gwidongOk/2026ALTIS/document/2026ALTIS V3 시험발사 운용 시나리오.docx

2026 ALTIS V3 아비오닉스 시험발사 운용 시나리오

대상 펌웨어: Final_v3/src/main.cpp | 문서 기준일: 2026-07-05

# 1. 발사 시퀀스

명령 | 응답 | 비고
CALIBRATE (센서보정) | CALIBRATION DONE. + beep 실패: IMU NOISY - RETRYING... + beep×3 | 수직 고정 후 실행
ERASE (플래시소거) | ERASING FLASH... → DONE. + beep | 이전 데이터 삭제
READY (발사준비) | READY CONVERGING - WAIT FOR ARMED 실패: KF ALIGN RETRY/BARO UNSTABLE + beep×3 | 보정·소거 선행 필수 홀센서 HIGH(결합) 아니면 거부 발사각 상태일 때 사용
(자동) 무장 | ARMED - LAUNCH DETECTION ACTIVE + beep×2 | 약 1분 소요, 흔들지 말 것
(자동) 발사확정 | LAUNCH CONFIRMED | 오 탐지 시 무장 전 단계로 자동 복귀
STOP (강제정지) | STOPPED. + beep×2 | 회수할떄 실행 (램에 있는 데이터 flash memory에 저장)
PARSE (로그덤프) | DUMP START → DUMP DONE | 후처리용 데이터 추출

# 2. 기타 명령

명령 | 사용 시점 | 응답
REBOOT(재부팅) | 언제나 | IMU+BARO OK → 1-AXIS READY
DISARM(무장해제) | 비행 중 제외 | DISARMED + beep(비행 중엔 ACK만, 무시됨)
TEST SERVO | 대기 상태 | SERVO OK + beep×2
TEST PYRO1(2단) | 대기 상태 | beep×3 → 1초 대기 → PYRO1 DONE
TEST PYRO2(메인) | 대기 상태 | beep×3 → 1초 대기 → PYRO2 DONE

# 3. 비행 중 자동 시퀀스

단계 | 전이 조건 | 동작
추진비행 → 관성비행 | 비력<2m/s² & 속도>10m/s, 또는 2초 경과 | BO
관성비행 | 홀센서 LOW (연속 3회) + 기울기 45도 이내 | STAGE2 IGN (1회) ※ 45도 초과: NSC TILT (영구보류)
관성비행 → 하강 | 상승속도<-0.5m/s & 고도>15m, 3번 연속 | APG, DROGUE※ 단분리 미확인 시 NSC NOSEP
하강 | 고도<100m | MAIN
하강 → 착륙완료 | 고도<10m & 속도<1m/s, 1초 | LAND, STOPPED. (로깅종료, beep×3)

# 4. 부저 신호

상황 | 패턴 | 의미
초기화 실패 | 0.1초×3, 이후 정지 | 재부팅 전까지 복구 불가
초기화 완료 / 보정 완료 / 파이로시험 완료 | 0.2초×1 | -
보정·정렬·영점 재시도 | 0.1초×3 | 자동 재시도 중
플래시소거 완료 | 0.5초×1 | -
서보시험 완료 / 무장 전환 | 0.1초×2 | -
파이로시험 점화 전 경고 | 0.05초×3 | 1초 후 점화
준비(수렴) 진입 / 강제정지 완료 | 0.2초×2 | -
무장해제 완료 | 0.1초×1 | -
착륙 자동감지 | 0.5초×3 | 로깅 자동 종료

# 5. 체크리스트

단계 | 확인 사항
전원 인가 | IMU+BARO OK / 1-AXIS READY 확인
보정 전 | 발사각 수직 고정, 흔들림 없음
파이로 시험 | 이매치 분리 후에만 실행
READY 전 | 보정·소거 완료 + 홀센서 결합상태(HIGH) 확인
무장 대기(~1분) | 기체 고정 유지, 흔들지 말 것
회수 직후 | STOP → 전원 차단
