gwidongOk/2026ALTIS/document/2차 시험발사 이후 피드백.pptx

해결방안
Calibrate -> Ready ->start
Ready시 초기자세와 초기고도만 가속도와 기압계센서로 측정 후 저장
Start시 자세적분, KF 실행
Start 명령이후 단기간안에 발사로 드리프트를 최소화

문제점
Calibrate -> start
Strat 이후는 KF, 밑 자세 적분 , launch 감지 전부 다 시작중
-> 이로 인해 자세에서 자세 적분으로 드리프트 발생

단계
초기자세 | 5.523 deg
Lauch 시점 자세 | 22.922 deg

## Slide 2

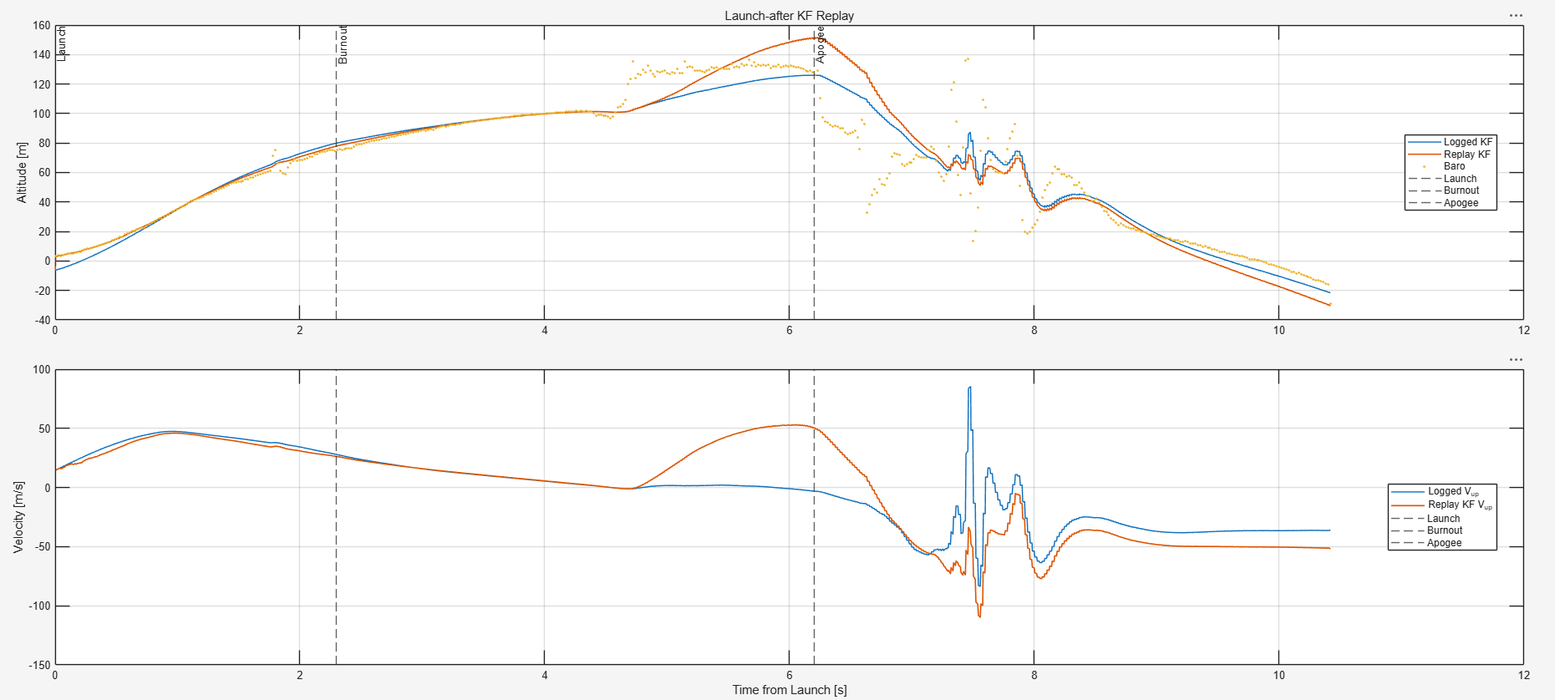
[picture p1: figure]
