gwidongOk/2026ALTIS/matlab/noise/baro_편향제거png.png

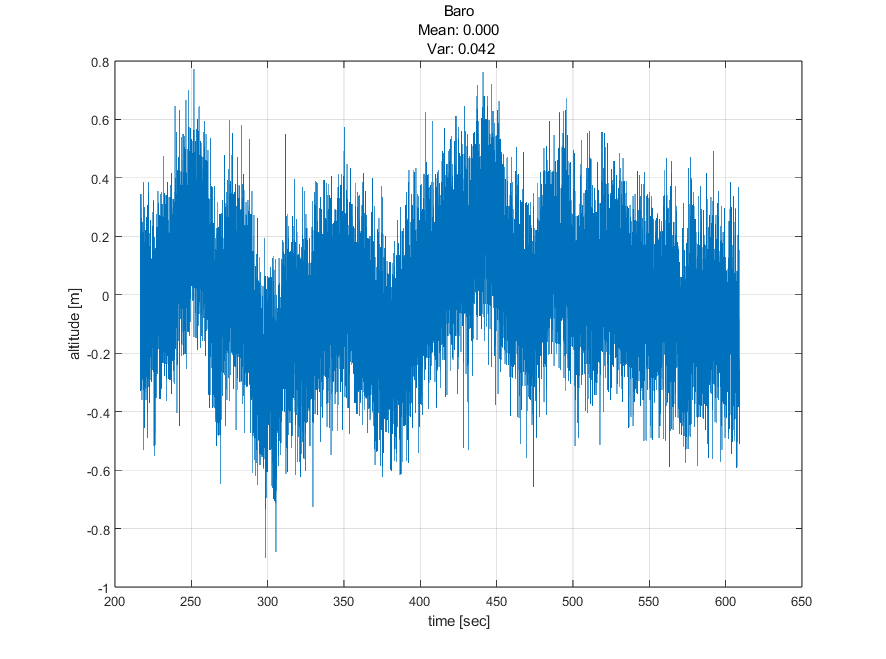
matlab/noise/baro_편향제거png.png
