gwidongOk/2026ALTIS/matlab/scenari/1D KF Monte Carlo_2.png

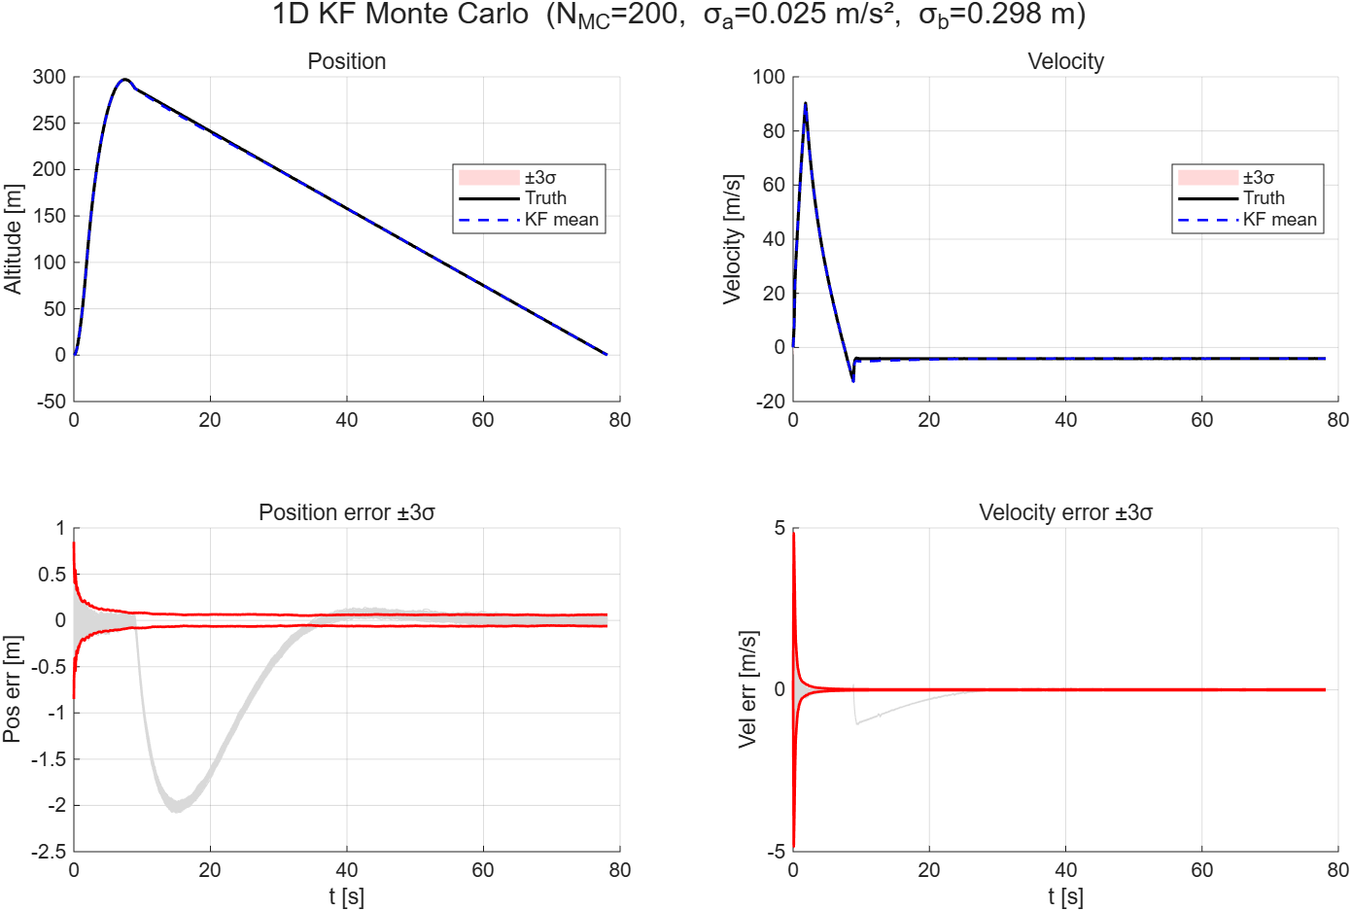
matlab/scenari/1D KF Monte Carlo_2.png
