gwidongOk/2026ALTIS/matlab/scenari/Fixed Q vs Adaptive Q.png

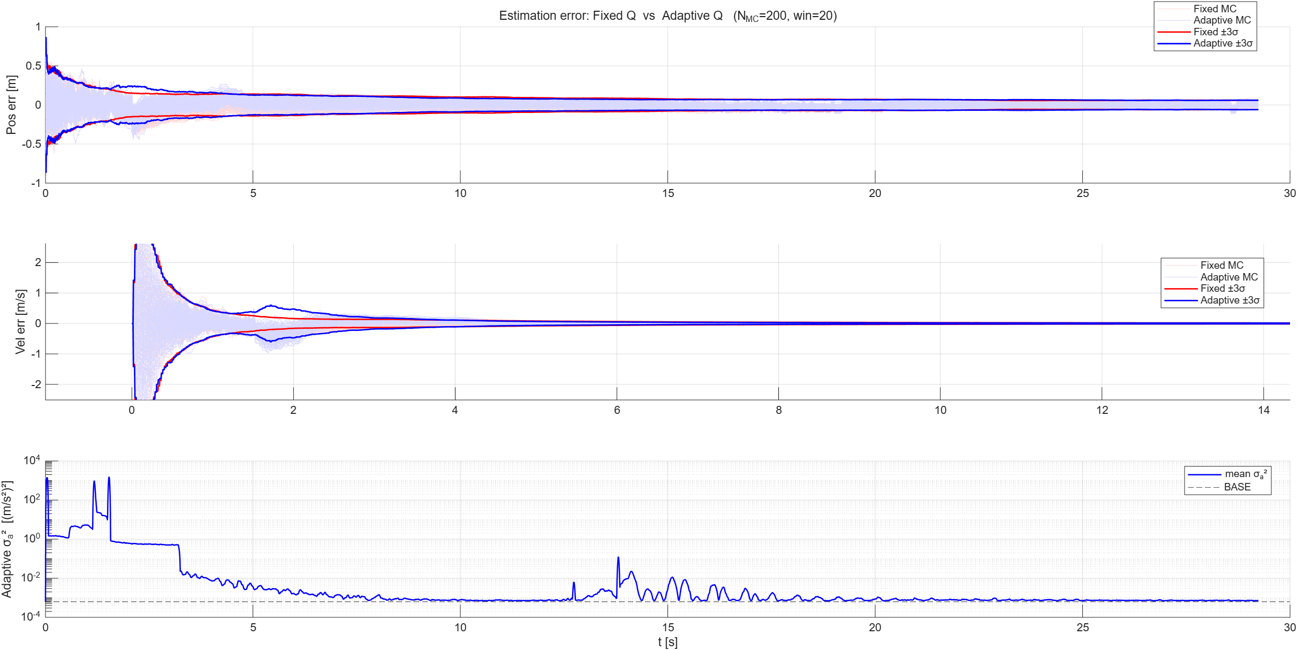
matlab/scenari/Fixed Q vs Adaptive Q.png
