gwidongOk/2026ALTIS/HW/BOM_PCB2_1_2026-06-29.xlsx

No. | Quantity | Comment | Designator | Footprint | Value | Manufacturer Part | Manufacturer | Supplier Part | Supplier
1 | 1 | 3kHz | BUZZER2 | BUZ-TH_BD9.6-P5.00-D0.7-FD | 3kHz | HNB09A05 | 华能 | C96493 | LCSC
2 | 1 | 220uF | C27 | CAP-SMD_BD10.0-L10.3-W10.3-LS11.3-FD | 220uF | UWT1H221MNL1GS | Nichicon(尼吉康) | C125977 | LCSC
3 | 3 | 330uF | C31,C63,C64 | CAP-SMD_BD8.0-L8.3-W8.3-LS10.0-FD | 330uF | RVT1E331M0810 | ROQANG(容强) | C335985 | LCSC
4 | 3 | 1uF | C33,C34,C35 | C1206 | 1uF | CL31B105KBHNNNE | SAMSUNG(三星) | C1848 | LCSC
5 | 1 | 33nF | C36 | C0805 | 33nF | 0805B333K500NT | FH(风华) | C1739 | LCSC
6 | 2 | 10uF | C39,C40 | CAP-SMD_L3.2-W1.6-RD-C7171 | 10uF | TAJA106K016RNJ | Kyocera AVX | C7171 | LCSC
7 | 12 | 100nF | C41,C42,C43,C48,C49,C52,C53,C54,C55,C69,C71,C72 | C0603 | 100nF | CC0603KRX7R9BB104 | YAGEO(国巨) | C14663 | LCSC
8 | 2 | 1uF | C56,C60 | C0603 | 1uF | CL10A105KB8NNNC | SAMSUNG(三星) | C15849 | LCSC
9 | 6 | 10uF | C57,C65,C68,C70,C73,C74 | C0603 | 10uF | CL10A106KP8NNNC | SAMSUNG(三星) | C19702 | LCSC
10 | 1 | XT30PW-M30.G.Y | CN5 | CONN-TH_XT30PW-M |  | XT30PW-M30.G.Y | AMASS(艾迈斯) | C431092 | LCSC
11 | 1 | USBLC6-2SC6 | D4 | SOT-23-6_L2.9-W1.6-P0.95-LS2.8-BL |  | USBLC6-2SC6 | UMW(友台半导体) | C2687116 | LCSC
12 | 1 | SS54 | D11 | SMA_L4.4-W2.8-LS5.4-R-RD |  | SS54 | MDD(辰达半导体) | C22452 | LCSC
13 | 1 | B5819W SL | D12 | SOD-123_L2.7-W1.6-LS3.7-RD-1 |  | B5819W SL | CJ(江苏长电/长晶) | C8598 | LCSC
14 | 1 | 1N4148WS | D13 | SOD-323_L1.8-W1.3-LS2.5-RD |  | 1N4148WS | CJ(江苏长电/长晶) | C2128 | LCSC
15 | 1 | ZMM3V3 | D14 | LL-34_L3.5-W1.5-RD |  | ZMM3V3 | Slkor(萨科微) | C707189 | LCSC
16 | 2 | 1N4007 | D15,D16 | SMA_L4.3-W2.5-LS5.0-RD |  | 1N4007 | TWGMC(迪嘉) | C727081 | LCSC
17 | 1 | 47uH | L1 | IND-SMD_L13.8-W12.8 | 47uH | CYA1265-47UH | SHOU HAN(首韩) | C19268672 | LCSC
18 | 4 | KT-0603R | LED4,LED5,LED6,LED7 | LED0603-RD |  | KT-0603R | KENTO | C2286 | LCSC
19 | 1 | AO3401A | Q9 | SOT-23_L2.9-W1.3-P1.90-LS2.4-BR |  | AO3401A | AOS | C15127 | LCSC
20 | 1 | SS8050(RANGE:200-350) | Q10 | SOT-23-3_L2.9-W1.3-P1.90-LS2.4-BR |  | SS8050(RANGE:200-350) | CJ(江苏长电/长晶) | C2150 | LCSC
21 | 2 | IRLR7843TR(UMW) | Q11,Q12 | TO-252-2_L6.5-W6.1-P4.58-LS10.0-BL |  | IRLR7843TR(UMW) | UMW(友台半导体) | C7499399 | LCSC
22 | 1 | 3.3kΩ | R37 | R0805 | 3.3kΩ | 0805W8F3301T5E | UNI-ROYAL(厚声) | C26010 | LCSC
23 | 1 | 10kΩ | R38 | R0805 | 10kΩ | 0805W8F1002T5E | UNI-ROYAL(厚声) | C17414 | LCSC
24 | 1 | 3.3kΩ | R42 | R0603 | 3.3kΩ | 0603WAF3301T5E | UNI-ROYAL(厚声) | C22978 | LCSC
25 | 1 | 24kΩ | R44 | R0603 | 24kΩ | 0603WAF2402T5E | UNI-ROYAL(厚声) | C23352 | LCSC
26 | 11 | 10kΩ | R45,R48,R53,R54,R62,R73,R74,R75,R76,R77,R78 | R0603 | 10kΩ | 0603WAF1002T5E | UNI-ROYAL(厚声) | C25804 | LCSC
27 | 2 | 200Ω | R46,R49 | R0603 | 200Ω | 0603WAF2000T5E | UNI-ROYAL(厚声) | C8218 | LCSC
28 | 5 | 1kΩ | R47,R50,R63,R64,R79 | R0603 | 1kΩ | 0603WAF1001T5E | UNI-ROYAL(厚声) | C21190 | LCSC
29 | 2 | 5.1kΩ | R60,R61 | R0603 | 5.1kΩ | 0603WAF5101T5E | UNI-ROYAL(厚声) | C23186 | LCSC
30 | 4 | 4.7kΩ | R65,R66,R67,R68 | R0603 | 4.7kΩ | 0603WAF4701T5E | UNI-ROYAL(厚声) | C23162 | LCSC
31 | 3 | TS-1088-AR02016 | SW1,SW2,SW3 | SW-SMD_L3.9-W3.0-P4.45 |  | TS-1088-AR02016 | XUNPU(讯普) | C720477 | LCSC
32 | 1 | ESP32-S3-WROOM-1-N16R8 | U2 | WIRELM-SMD_ESP32-S3-WROOM-1 |  | ESP32-S3-WROOM-1-N16R8 | ESPRESSIF(乐鑫) | C2913202 | LCSC
33 | 1 | XL4015E1 | U3 | TO-263-5_L10.2-W8.9-P1.70-TL |  | XL4015E1 | XLSEMI(芯龙) | C51661 | LCSC
34 | 1 | AMS1117-3.3 | U4 | SOT-223-3_L6.5-W3.4-P2.30-LS7.0-BR |  | AMS1117-3.3 | AMS | C6186 | LCSC
35 | 1 | LSM6DSO32TR | U7 | LGA-14_L3.0-W2.5-P0.50-TL |  | LSM6DSO32TR | ST(意法半导体) | C1864162 | LCSC
36 | 1 | BMP388 | U10 | SENSORM-SMD_BMP388 |  | BMP388 | Bosch(博世) | C779278 | LCSC
37 | 1 | MX25L25645GM2I-08G | U17 | SOIC-8_L5.3-W5.3-P1.27-LS8.0-BL |  | MX25L25645GM2I-08G | MXIC(旺宏电子) | C190799 | LCSC
38 | 1 | FG-ST-C-16P-RAT-7.35 | USB3 | USB-C-SMD_FG-ST-C-16P-RAT-7.35 |  | FG-ST-C-16P-RAT-7.35 | FG(富港) | C51911914 | LCSC
