gwidongOk/2026ALTIS/test_accel.png

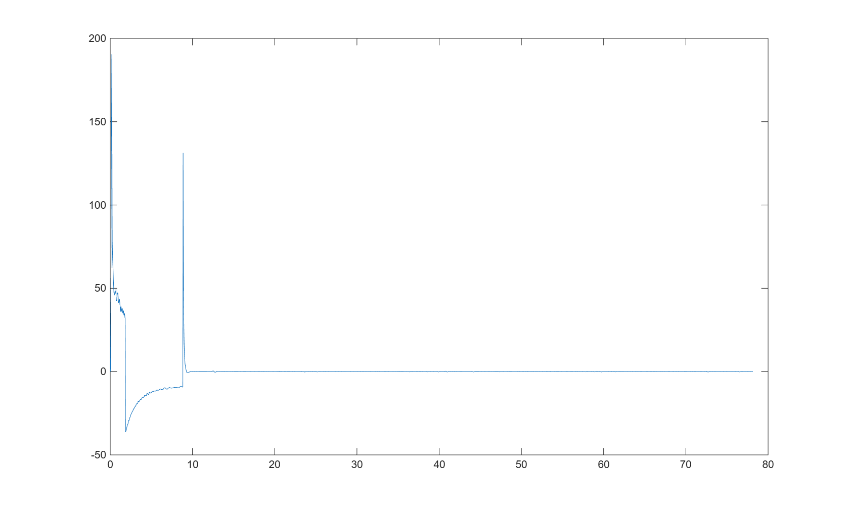
test_accel.png
