gwidongOk/2026ALTIS/(list of files, drawings)

Other design files:
HW/1_ESP32.schdoc
HW/2_Sensor.schdoc
HW/3_Power.schdoc
HW/PCB2.pcbdoc
