gwidongOk/2026ALTIS/SW/Final_v5/src/MX25Logger.cpp

#include "MX25Logger.h"
#include <freertos/FreeRTOS.h>
#include <freertos/task.h>

// ============================================================
// PreTriggerBuffer
// ============================================================
bool PreTriggerBuffer::begin(size_t capacity) {
  if (capacity == 0) return false;

  _records = static_cast<Record *>(heap_caps_malloc(
      capacity * sizeof(Record), MALLOC_CAP_SPIRAM | MALLOC_CAP_8BIT));
  if (!_records) return false;

  _capacity = capacity;
  clear();
  return true;
}

void PreTriggerBuffer::clear() {
  portENTER_CRITICAL(&_mux);
  _head = 0;
  _count = 0;
  _frozen = false;
  portEXIT_CRITICAL(&_mux);
}

void PreTriggerBuffer::freeze() {
  portENTER_CRITICAL(&_mux);
  _frozen = true;
  portEXIT_CRITICAL(&_mux);
}

void PreTriggerBuffer::pushImu(const Raw_imu &raw) {
  Record record = {};
  record.type = RECORD_IMU;
  record.imu = raw;
  push(record);
}

void PreTriggerBuffer::pushBaro(const Raw_press &baro) {
  Record record = {};
  record.type = RECORD_BARO;
  record.baro = baro;
  push(record);
}

void PreTriggerBuffer::pushState(const State_nominal &state) {
  Record record = {};
  record.type = RECORD_STATE;
  record.state = state;
  push(record);
}

void PreTriggerBuffer::pushEvent(
    FlightPhase phase, uint8_t eventId, uint32_t timestamp) {
  Record record = {};
  record.type = RECORD_EVENT;
  record.event.timestamp = timestamp;
  record.event.phase = static_cast<uint8_t>(phase);
  record.event.eventId = eventId;
  push(record);
}

void PreTriggerBuffer::push(const Record &record) {
  portENTER_CRITICAL(&_mux);
  if (!_records || _capacity == 0 || _frozen) {
    portEXIT_CRITICAL(&_mux);
    return;
  }

  _records[_head] = record;
  _head = (_head + 1) % _capacity;
  if (_count < _capacity) _count++;
  portEXIT_CRITICAL(&_mux);
}

size_t PreTriggerBuffer::size() {
  portENTER_CRITICAL(&_mux);
  size_t count = _count;
  portEXIT_CRITICAL(&_mux);
  return count;
}

bool PreTriggerBuffer::getOldest(size_t index, Record &out) {
  portENTER_CRITICAL(&_mux);
  if (!_records || index >= _count) {
    portEXIT_CRITICAL(&_mux);
    return false;
  }

  size_t oldest = (_head + _capacity - _count) % _capacity;
  out = _records[(oldest + index) % _capacity];
  portEXIT_CRITICAL(&_mux);
  return true;
}

#define CMD_WREN         0x06
#define CMD_RDSR         0x05
#define CMD_WRITE        0x02
#define CMD_READ         0x03
#define CMD_EN4B         0xB7
#define CMD_SECTOR_ERASE 0x20
#define CMD_CHIP_ERASE   0xC7

// NVS 키

MX25Logger::MX25Logger() {
  _spi = nullptr;
  _bufferIndex = 0;
  _currentFlashAddress = 0x0000000;
  _bufferMutex = xSemaphoreCreateMutex();
  _spiMutex = nullptr;
  _queue = NULL;
  _queueStorage = nullptr;
  _queueLength = 0;
  _droppedItems = 0;
  _enabled = false;
}

bool MX25Logger::begin(SPIClass *spi, int sck, int miso, int mosi, int cs, SemaphoreHandle_t spiMutex) {
  // Keep 2 MB PSRAM in reserve for the rest of the application and use the
  // remainder for the logging queue. This board has 8 MB PSRAM.
  size_t freePsram = ESP.getFreePsram();
  if (freePsram > PSRAM_RESERVE_BYTES) {
    size_t usableBytes = freePsram - PSRAM_RESERVE_BYTES;
    _queueLength = usableBytes / sizeof(Item);
    if (_queueLength > MAX_QUEUE_ITEMS) _queueLength = MAX_QUEUE_ITEMS;

    size_t queueBytes = _queueLength * sizeof(Item);
    _queueStorage = (uint8_t *)heap_caps_malloc(
        queueBytes, MALLOC_CAP_SPIRAM | MALLOC_CAP_8BIT);
    if (_queueStorage) {
      _queue = xQueueCreateStatic(
          (UBaseType_t)_queueLength, sizeof(Item), _queueStorage, &_queueControl);
    }
  }

  // No internal-RAM fallback: if the PSRAM queue can't be allocated, fail
  // the boot the same way every other critical init failure does (caller
  // halts on a false return) rather than silently logging with a queue too
  // small to be useful.
  if (!_queue) return false;
  Serial.printf("Log queue: %u items (%u bytes) in PSRAM\n",
                (unsigned)_queueLength,
                (unsigned)(_queueLength * sizeof(Item)));

  _spi = spi;
  _csPin = cs;
  _spiMutex = spiMutex;
  _bufferIndex = 0;

  pinMode(_csPin, OUTPUT);
  digitalWrite(_csPin, HIGH);
  
  if (_spiMutex) xSemaphoreTake(_spiMutex, portMAX_DELAY);
  _spi->begin(sck, miso, mosi, _csPin);
  enter4ByteMode();
  if (_spiMutex) xSemaphoreGive(_spiMutex);

  vTaskDelay(pdMS_TO_TICKS(10));

  // NVS에서 이전 기록 종료 주소 복원
  _currentFlashAddress = START_ADDRESS;

  return true;
}

// ============================================================
// 버퍼/페이지 관리
// ============================================================
bool MX25Logger::hasFullPage() {
  xSemaphoreTake(_bufferMutex, portMAX_DELAY);
  bool result = (_bufferIndex >= 256);
  xSemaphoreGive(_bufferMutex);
  return result;
}

void MX25Logger::flushPages() {
  xSemaphoreTake(_bufferMutex, portMAX_DELAY);

  while (_bufferIndex >= 256) {
    uint8_t page[256];
    memcpy(page, _dataBuffer, 256);

    uint16_t remaining = _bufferIndex - 256;
    if (remaining > 0) {
      memmove(_dataBuffer, &_dataBuffer[256], remaining);
    }
    _bufferIndex = remaining;

    xSemaphoreGive(_bufferMutex);

    writePage(page);

    xSemaphoreTake(_bufferMutex, portMAX_DELAY);
  }

  xSemaphoreGive(_bufferMutex);
}

void MX25Logger::writePage(uint8_t *page) {
  // 플래시 끝 도달 시 자동으로 로깅 중지 (덮어쓰기 방지)
  if (_currentFlashAddress + 256 > MAX_ADDRESS) {
    if (_enabled) {
      _enabled = false;
      Serial.println("Flash FULL — logging disabled");
    }
    return;
  }

  if (_spiMutex) xSemaphoreTake(_spiMutex, portMAX_DELAY);

  // Note: Erase is handled pre-flight via eraseAll() to avoid latency.
  writeEnable();
  digitalWrite(_csPin, LOW); _spi->transfer(CMD_WRITE);
  _spi->transfer((_currentFlashAddress >> 24) & 0xFF);
  _spi->transfer((_currentFlashAddress >> 16) & 0xFF);
  _spi->transfer((_currentFlashAddress >> 8) & 0xFF);
  _spi->transfer(_currentFlashAddress & 0xFF);

  for (uint16_t i = 0; i < 256; i++) { _spi->transfer(page[i]); }
  digitalWrite(_csPin, HIGH);
  waitUntilDone();

  _currentFlashAddress += 256;

  if (_spiMutex) xSemaphoreGive(_spiMutex);
}

void MX25Logger::forceFlushBuffer() {
  // Logging is disabled by the caller before shutdown/dump. Drain every
  // packet still staged in the large queue before writing the tail page.
  Item queued;
  while (_queue && xQueueReceive(_queue, &queued, 0) == pdTRUE) {
    appendRaw(queued.data, queued.len);
    if (hasFullPage()) flushPages();
  }

  flushPages();

  xSemaphoreTake(_bufferMutex, portMAX_DELAY);
  if (_bufferIndex == 0) {
    xSemaphoreGive(_bufferMutex);
    return;
  }

  uint8_t remaining[256];
  uint16_t len = _bufferIndex;
  memcpy(remaining, _dataBuffer, len);
  _bufferIndex = 0;
  xSemaphoreGive(_bufferMutex);

  // 플래시 끝 도달 시 잔여 데이터 폐기
  if (_currentFlashAddress + len > MAX_ADDRESS) {
    Serial.println("Flash FULL — dropping tail buffer");
    return;
  }

  if (_spiMutex) xSemaphoreTake(_spiMutex, portMAX_DELAY);

  // Note: Erase is handled pre-flight via eraseAll() to avoid latency.
  writeEnable();
  digitalWrite(_csPin, LOW); _spi->transfer(CMD_WRITE);
  _spi->transfer((_currentFlashAddress >> 24) & 0xFF);
  _spi->transfer((_currentFlashAddress >> 16) & 0xFF);
  _spi->transfer((_currentFlashAddress >> 8) & 0xFF);
  _spi->transfer(_currentFlashAddress & 0xFF);

  for (uint16_t i = 0; i < len; i++) { _spi->transfer(remaining[i]); }
  digitalWrite(_csPin, HIGH);
  waitUntilDone();

  _currentFlashAddress += len;
  
  if (_spiMutex) xSemaphoreGive(_spiMutex);

  if (_droppedItems > 0) {
    Serial.printf("Log queue dropped %u packets\n", (unsigned)_droppedItems);
  }
}

// ============================================================
// 읽기/덤프
// ============================================================
void MX25Logger::dumpRawBinary(Stream &out) {
  uint32_t readAddr = START_ADDRESS;
  uint8_t buffer[256];
  while (readAddr < MAX_ADDRESS) {
    uint32_t readLen = MAX_ADDRESS - readAddr;
    if (readLen > 256) readLen = 256;

    readFlash(readAddr, buffer, readLen);
    out.write(buffer, readLen);

    readAddr += readLen;
    vTaskDelay(pdMS_TO_TICKS(1));
  }
  out.flush();
}

// ============================================================
// 전체 삭제
// ============================================================
void MX25Logger::eraseAll() {
  if (_spiMutex) xSemaphoreTake(_spiMutex, portMAX_DELAY);

  writeEnable();
  digitalWrite(_csPin, LOW);
  _spi->transfer(CMD_CHIP_ERASE);
  digitalWrite(_csPin, HIGH);

  digitalWrite(_csPin, LOW);
  _spi->transfer(CMD_RDSR);
  while ((_spi->transfer(0x00) & 0x01) == 1) {
    vTaskDelay(pdMS_TO_TICKS(100));
  }
  digitalWrite(_csPin, HIGH);

  if (_spiMutex) xSemaphoreGive(_spiMutex);

  _currentFlashAddress = START_ADDRESS;
  _bufferIndex = 0;
  _droppedItems = 0;

}

// ============================================================
// 저수준 Flash 명령 (내부용, 뮤텍스는 상위에서 잡아야 함)
// ============================================================
void MX25Logger::readFlash(uint32_t addr, uint8_t *buf, uint32_t len) {
  if (_spiMutex) xSemaphoreTake(_spiMutex, portMAX_DELAY);
  digitalWrite(_csPin, LOW); _spi->transfer(CMD_READ);
  _spi->transfer((addr >> 24) & 0xFF); _spi->transfer((addr >> 16) & 0xFF);
  _spi->transfer((addr >> 8) & 0xFF); _spi->transfer(addr & 0xFF);
  for (uint32_t i = 0; i < len; i++) { buf[i] = _spi->transfer(0x00); }
  digitalWrite(_csPin, HIGH);
  if (_spiMutex) xSemaphoreGive(_spiMutex);
}

void MX25Logger::eraseSector(uint32_t addr) {
  // NOTE: 상위 writePage/forceFlush에서 이미 뮤텍스를 잡았거나 잡아야 함.
  // 여기서는 중복해서 잡지 않음 (필요시 재귀 뮤텍스 사용 가능하나 ESP32 기본은 아님)
  digitalWrite(_csPin, LOW); _spi->transfer(CMD_SECTOR_ERASE);
  _spi->transfer((addr >> 24) & 0xFF); _spi->transfer((addr >> 16) & 0xFF);
  _spi->transfer((addr >> 8) & 0xFF); _spi->transfer(addr & 0xFF);
  digitalWrite(_csPin, HIGH);
}

void MX25Logger::writeEnable() {
  digitalWrite(_csPin, LOW); _spi->transfer(CMD_WREN); digitalWrite(_csPin, HIGH);
}

void MX25Logger::waitUntilDone() {
  digitalWrite(_csPin, LOW); _spi->transfer(CMD_RDSR);
  while ((_spi->transfer(0x00) & 0x01) == 1) {
    vTaskDelay(pdMS_TO_TICKS(1));
  }
  digitalWrite(_csPin, HIGH);
}

void MX25Logger::enter4ByteMode() {
  digitalWrite(_csPin, LOW); _spi->transfer(CMD_EN4B); digitalWrite(_csPin, HIGH);
}

// ============================================================
// Typed log methods
// ============================================================
void MX25Logger::logImu(const Raw_imu &raw) {
  imu_pkt pkt;
  pkt.header.SYNC_BYTE = 0xAA;
  pkt.header.id        = ID_IMU;
  pkt.header.len       = sizeof(pkt);
  pkt.t  = raw.timestamp;
  pkt.gx = raw.gx; pkt.gy = raw.gy; pkt.gz = raw.gz;
  pkt.ax = raw.ax; pkt.ay = raw.ay; pkt.az = raw.az;
  _push(&pkt, sizeof(pkt));
}

void MX25Logger::logBaro(const Raw_press &p) {
  baro_pkt pkt;
  pkt.header.SYNC_BYTE = 0xAA;
  pkt.header.id        = ID_BARO;
  pkt.header.len       = sizeof(pkt);
  pkt.t   = p.timestamp;
  pkt.alt = p.alt;
  _push(&pkt, sizeof(pkt));
}

void MX25Logger::logState(const State_nominal &nom) {
  state_pkt pkt;
  pkt.header.SYNC_BYTE = 0xAA;
  pkt.header.id        = ID_STATE;
  pkt.header.len       = sizeof(pkt);
  pkt.t = nom.timestamp;
  memcpy(pkt.p, nom.p, sizeof(nom.p));
  memcpy(pkt.v, nom.v, sizeof(nom.v));
  memcpy(pkt.q, nom.q, sizeof(nom.q));
  _push(&pkt, sizeof(pkt));
}

void MX25Logger::logEvent(FlightPhase phase, uint8_t eventId) {
  event_pkt pkt;
  pkt.header.SYNC_BYTE = 0xAA;
  pkt.header.id        = ID_EVENT;
  pkt.header.len       = sizeof(pkt);
  pkt.t = (uint32_t)(esp_timer_get_time() & 0xFFFFFFFF);
  pkt.phase    = (uint8_t)phase;
  pkt.event_id = eventId;
  _push(&pkt, sizeof(pkt));
}

bool MX25Logger::appendPreTriggerRecord(
    const PreTriggerBuffer::Record &record) {
  if (record.type == PreTriggerBuffer::RECORD_IMU) {
    imu_pkt pkt;
    pkt.header.SYNC_BYTE = 0xAA;
    pkt.header.id        = ID_IMU;
    pkt.header.len       = sizeof(pkt);
    pkt.t  = record.imu.timestamp;
    pkt.gx = record.imu.gx;
    pkt.gy = record.imu.gy;
    pkt.gz = record.imu.gz;
    pkt.ax = record.imu.ax;
    pkt.ay = record.imu.ay;
    pkt.az = record.imu.az;
    appendRaw(reinterpret_cast<const uint8_t *>(&pkt), sizeof(pkt));
    return true;
  }

  if (record.type == PreTriggerBuffer::RECORD_BARO) {
    baro_pkt pkt;
    pkt.header.SYNC_BYTE = 0xAA;
    pkt.header.id        = ID_BARO;
    pkt.header.len       = sizeof(pkt);
    pkt.t   = record.baro.timestamp;
    pkt.alt = record.baro.alt;
    appendRaw(reinterpret_cast<const uint8_t *>(&pkt), sizeof(pkt));
    return true;
  }

  if (record.type == PreTriggerBuffer::RECORD_STATE) {
    state_pkt pkt;
    pkt.header.SYNC_BYTE = 0xAA;
    pkt.header.id        = ID_STATE;
    pkt.header.len       = sizeof(pkt);
    pkt.t = record.state.timestamp;
    memcpy(pkt.p, record.state.p, sizeof(record.state.p));
    memcpy(pkt.v, record.state.v, sizeof(record.state.v));
    memcpy(pkt.q, record.state.q, sizeof(record.state.q));
    appendRaw(reinterpret_cast<const uint8_t *>(&pkt), sizeof(pkt));
    return true;
  }

  if (record.type == PreTriggerBuffer::RECORD_EVENT) {
    event_pkt pkt;
    pkt.header.SYNC_BYTE = 0xAA;
    pkt.header.id        = ID_EVENT;
    pkt.header.len       = sizeof(pkt);
    pkt.t        = record.event.timestamp;
    pkt.phase    = record.event.phase;
    pkt.event_id = record.event.eventId;
    appendRaw(reinterpret_cast<const uint8_t *>(&pkt), sizeof(pkt));
    return true;
  }

  return false;
}

void MX25Logger::serviceFlush() {
  Item item;
  size_t drained = 0;
  while (drained < SERVICE_BATCH_ITEMS &&
         xQueueReceive(_queue, &item, 0) == pdTRUE) {
    appendRaw(item.data, item.len);
    drained++;
  }
  if (hasFullPage()) {
    flushPages();
  }
}

void MX25Logger::_push(const void *pkt, uint8_t len) {
  if (!_enabled) return;
  if (len > ITEM_MAX_SIZE) return;
  Item item;
  item.len = len;
  memcpy(item.data, pkt, len);
  if (xQueueSend(_queue, &item, 0) != pdTRUE) {
    _droppedItems++;
  }
}
