gwidongOk/2026ALTIS/(commit log)

2026-05-06 Please enter the commit message for your changes. Lines starting with '#' will be ignored, and an empty message aborts the commit.
    On branch main
    Your branch is up to date with 'origin/main'.
    Changes to be committed:
    new file: HW/1_ESP32.schdoc
    new file: HW/2_Sensor.schdoc
    new file: HW/3_Power.schdoc
    new file: HW/PCB2.pcbdoc
    new file: HW/README.md
    new file: SW/README.md
    new file: SW/final/.gitignore
    new file: SW/final/.vscode/extensions.json
    new file: SW/final/architecture.html
    new file: SW/final/include/README
    new file: SW/final/lib/README
    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
    [1_ESP32.schdoc, 2_Sensor.schdoc, 3_Power.schdoc, PCB2.pcbdoc, gps_20260418.xlsx, imu_20260413.xlsx, mag_20260420.xlsx, openrocket.csv]
2026-05-07 new file: SW/noise_measurement/.gitignore new file: SW/noise_measurement/.vscode/extensions.json new file: SW/noise_measurement/include/README new file: SW/noise_measurement/lib/README new file: SW/n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
    [BLE.cpp, BLE.h, BMP388.cpp, BMP388.h, Config.h, LSM6DSO32.cpp, LSM6DSO32.h, MX25Logger.cpp]
2026-05-07 modified: SW/parse/__pycache__/header_parser.cpython-310.pyc modified: SW/parse/main.py new file: matlab/noise/accel.png new file: matlab/noise/baro.png new file: "matlab/noise/baro_\355\216\270\355\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
    [gps_20260418.xlsx, imu_baro.xlsx, mag_20260420.xlsx]
2026-05-11 deleted: SW/imu_baro_gps_mag_flash_rtos/src/ESEKF.cpp deleted: SW/imu_baro_gps_mag_flash_rtos/src/ESEKF.h new file: SW/imu_baro_gps_mag_flash_rtos/src/KF1D.cpp new file: SW/imu_baro_gps_mag_flash_rto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
2026-05-12 new file: "SW/imu_baro_gps_mag_flash_rtos/src/2\353\213\250\353\266\200\354\227\220\353\271\204\354\230\244\353\213\211\354\212\244.pdf" modified: SW/imu_baro_gps_mag_flash_rtos/src/KF1D.cpp modified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
    [KF1D.cpp, KF1D.h, NAV.cpp, NAV.h, main.cpp]
2026-05-18 new file: .claude/worktrees/stupefied-lalande-7a6d53 new file: .claude/worktrees/unruffled-brahmagupta-7c0d1d renamed: SW/final/.gitignore -> SW/Final_v2/.gitignore renamed: SW/final/.vscode/extensio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
    [2stage.csv, 2stage_no_parachute.csv, HIL.csv, openrocket.csv]
2026-05-18 deleted: "document/~$26ALTIS \354\232\264\354\232\251 \353\247\244\353\211\264\354\226\274.docx"
    Changes not staged for commit:
    modified: .claude/worktrees/stupefied-lalande-7a6d53 (untracked content)
    modified: .claude/worktrees/unruffled-brahmagupta-7c0d1d (untracked content)
    modified: SW/Final_v2/src/.claude/worktrees/magical-mestorf-b794e7 (modified content, untracked content)
2026-05-22 Please enter the commit message for your changes. Lines starting with '#' will be ignored, and an empty message aborts the commit.
    new file: .claude/worktrees/fervent-ardinghelli-63c455
    new file: .claude/worktrees/sharp-bohr-d0bcb4
    new file: .claude/worktrees/zen-hypatia-6eca2f
    modified: SW/Final_v2/platformio.ini
    new file: SW/Final_v2/src/2026ALTIS.code-workspace
    modified: SW/Final_v2/src/Config.h
    modified: SW/Final_v2/src/KF1D.h
    modified: SW/Final_v2/src/LSM6DSO32.cpp
    modified: SW/Final_v2/src/LSM6DSO32.h
    modified: SW/Final_v2/src/NAV.cpp
    modified: SW/Final_v2/src/main.cp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
    [2stage.csv, 2stage_no_parachute.csv, openrocket.csv]
2026-05-22 Please enter the commit message for your changes. Lines starting with '#' will be ignored, and an empty message aborts the commit.
    Your branch is ahead of 'origin/main' by 1 commit.
    (use "git push" to publish your local commits)
    modified: "document/2026ALTIS \354\232\264\354\232\251 \353\247\244\353\211\264\354\226\274.docx"
    deleted: "document/~$26ALTIS \354\232\264\354\232\251 \353\247\244\353\211\264\354\226\274.docx"
    modified: .claude/worktrees/fervent-ardinghelli-63c455 (untracked content)
    modified: .claude/worktrees/sharp-bohr-d0bcb4 (untracked content)
    modified: .claude/worktrees/stupefied-laland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
2026-05-25 renamed: SW/Final_v2/result/20260524_7.mp4 -> SW/Final_v2/result/20260524.zip deleted: SW/Final_v2/result/20260524_1.mp4 deleted: SW/Final_v2/result/20260524_2.mp4 deleted: SW/Final_v2/result/2026052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
    de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
2026-05-25 On branch main Changes to be committed: modified: .claude/worktrees/fervent-ardinghelli-63c455 modified: .claude/worktrees/sharp-bohr-d0bcb4 modified: .claude/worktrees/stupefied-lalande-7a6d53 modif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
    modified: .claude/worktrees/stupefied-lalande-7a6d5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
2026-05-31 Please enter the commit message for your changes. Lines starting with '#' will be ignored, and an empty message aborts the commit.
    renamed: matlab/after/montecarlo_sim.m -> matlab/after/flight_after.m
    modified: SW/Final_v2/src/.claude/worktrees/magical-mestorf-b794e7 (modified content)
    modified: matlab/after/flight_after.m
    Untracked files:
    "document/2\354\260\250 \354\213\234\355\227\230\353\260\234\354\202\254 \354\235\264\355\233\204 \355\224\274\353\223\234\353\260\261.pptx"
    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
2026-05-31 Please enter the commit message for your changes. Lines starting with '#' will be ignored, and an empty message aborts the commit.
    new file: "document/2\354\260\250 \354\213\234\355\227\230\353\260\234\354\202\254 \354\235\264\355\233\204 \355\224\274\353\223\234\353\260\261.pptx"
    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
2026-05-31 Please enter the commit message for your changes. Lines starting with '#' will be ignored, and an empty message aborts the commit.
    modified: "document/2\354\260\250 \354\213\234\355\227\230\353\260\234\354\202\254 \354\235\264\355\233\204 \355\224\274\353\223\234\353\260\261.pptx"
    new file: "document/~$2\354\260\250 \354\213\234\355\227\230\353\260\234\354\202\254 \354\235\264\355\233\204 \355\224\274\353\223\234\353\260\261.pptx"
    modified: SW/Final_v2/src/.claude/worktrees/magical-mesto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
2026-07-05 new file: SW/Final_v3/ground_test/ground_test.ino modified: SW/Final_v3/src/BMP388.cpp modified: SW/Final_v3/src/BMP388.h modified: SW/Final_v3/src/Config.h deleted: SW/Final_v3/src/HIL.cpp deleted: 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
    modified: .claude/worktrees/unruffled-brahmagupta-7c0d1d (untracked conten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
2026-07-05 Please enter the commit message for your changes. Lines starting with '#' will be ignored, and an empty message aborts the commit.
    modified: SW/Final_v3/ground_test/ground_test.ino
    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
2026-07-05 Please enter the commit message for your changes. Lines starting with '#' will be ignored, and an empty message aborts the commit.
    modified: SW/Final_v3/src/Config.h
    modified: SW/Final_v3/src/main.cpp
    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
2026-07-05 Please enter the commit message for your changes. Lines starting with '#' will be ignored, and an empty message aborts the commit.
    new file: "document/2026ALTIS V3 \354\213\234\355\227\230\353\260\234\354\202\254 \354\232\264\354\232\251 \354\213\234\353\202\230\353\246\254\354\230\244.docx"
    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
2026-07-12 Please enter the commit message for your changes. Lines starting with '#' will be ignored, and an empty message aborts the commit.
    deleted: .claude/worktrees/fervent-ardinghelli-63c455
    deleted: .claude/worktrees/stupefied-lalande-7a6d53
    deleted: .claude/worktrees/zen-hypatia-6eca2f
    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
